EmanuelDecima/Fuente-Variable-con-Microcontrolador/Diagrama de bloques.png

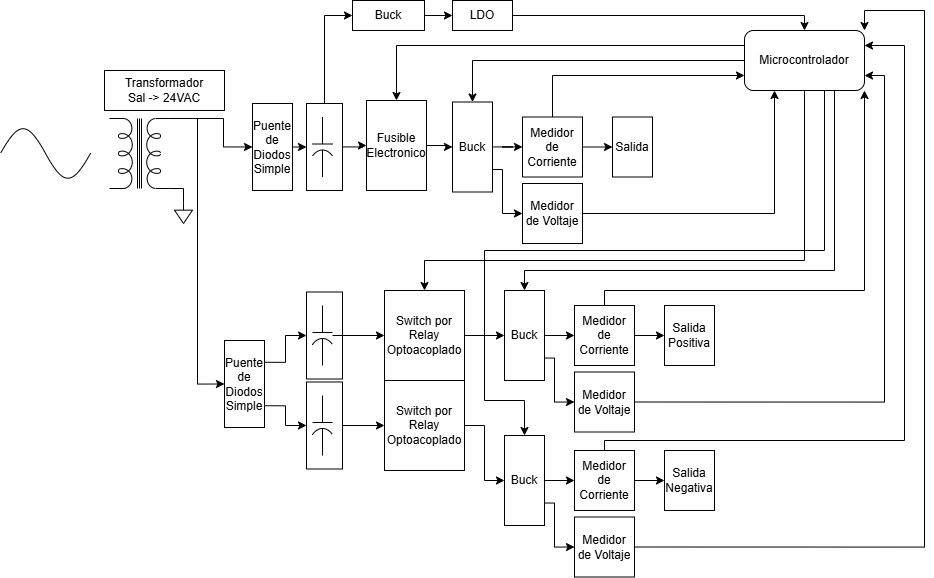
Diagrama de bloques.png
