EmanuelDecima/Fuente-Variable-con-Microcontrolador/Doc/Archivos de Impresion/PCB_Back.pdf

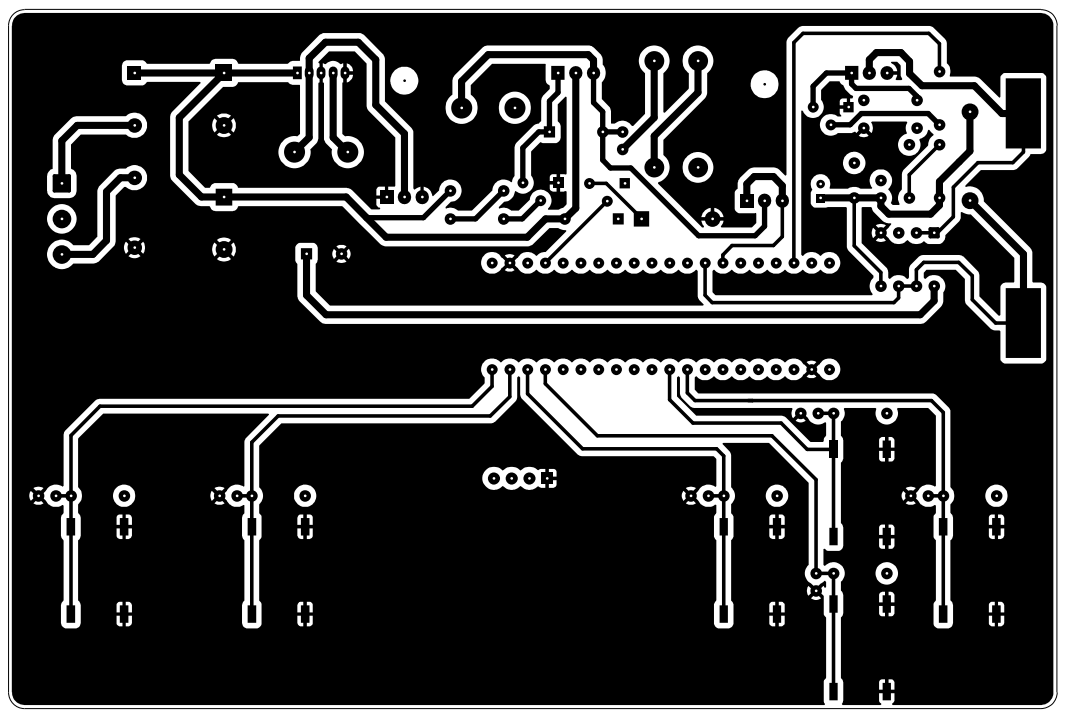
[picture p19: page 1]
