EmanuelDecima/Fuente-Variable-con-Microcontrolador/Doc/Archivos de Impresion/PCB_Front.pdf

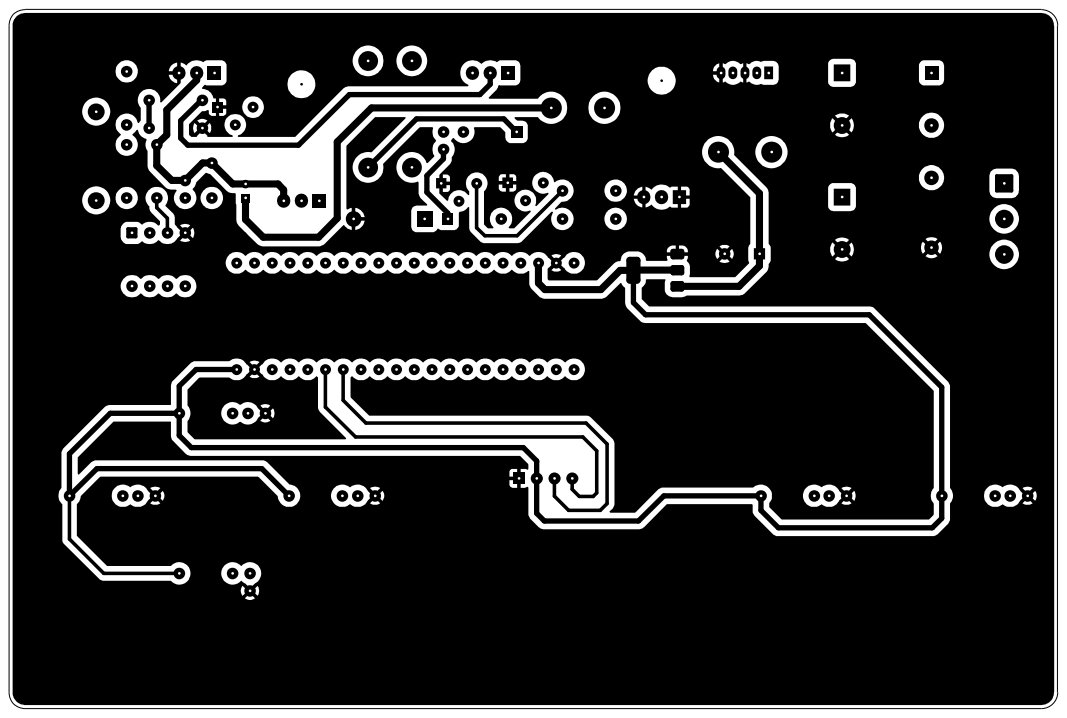
[picture p20: page 1]
