EmanuelDecima/Fuente-Variable-con-Microcontrolador/Simulaciones/FusibleElectronico.asc

M1: nmos; AON6162
Q1: npn; 2N3904
R1: res; 6.8k
R2: res; 1k
R3: res; 820
RL: res; 15
V1: voltage; SINE(31.84 3.18 100)
V2: voltage; PULSE(0 3.3 50m 1n 1n 100m 200m)
Named nets: 0
.tran 1
