EmanuelDecima/Fuente-Variable-con-Microcontrolador/Simulaciones/PuenteDiodos.asc

C1: cap; 2200µ
D1: diode
D2: diode
D3: diode
D4: diode
R1: res; 80
RL: res; 2.7k
V1: signal; SINE(0 37.15 50)
Named nets: 0, Salida
.tran 10
