EmanuelDecima/Fuente-Variable-con-Microcontrolador/Simulaciones/BuckPrincipal-Bootstrap.asc

C1: cap; 82n
C2: cap; 8.2n
C3: cap; 100µ
D1: schottky; MBRB2545CT
D2: schottky; 1N5818
D3: schottky; 1N5818
D4: zener; UFZV10B
L1: ind; 4.7m
M1: nmos; BSB015N04NX3
M4: nmos; 2N7002
Q1: npn; 2N3904
R1: res; 3.9
R2: res; 150
R3: res; 150
R4: res; 3.3k
R6: res; 5.6k
V1: voltage; 31.84
V2: signal; PULSE(0 3.3 0.1m 1n 1n 15u 40u)
Named nets: 0
.tran 50m
*.step param ton 0.126u 1.57u 0.1u
*.step param ton list 2.52u 15u 31.4u 37.78u
