EmanuelDecima/Fuente-Variable-con-Microcontrolador/(commit log)

2025-11-07 Diagrama de bloques
2025-11-12 Simulacion de etapa Buck Principal
2025-11-12 Cambio en valor de capacitor (ahorro de costos)
2026-03-19 Actualizacion de Documentacion
